osemenyuk-114/RGBtoHDMI/Kicad_6Bit/v7a/SLW-105-01-T-D.step

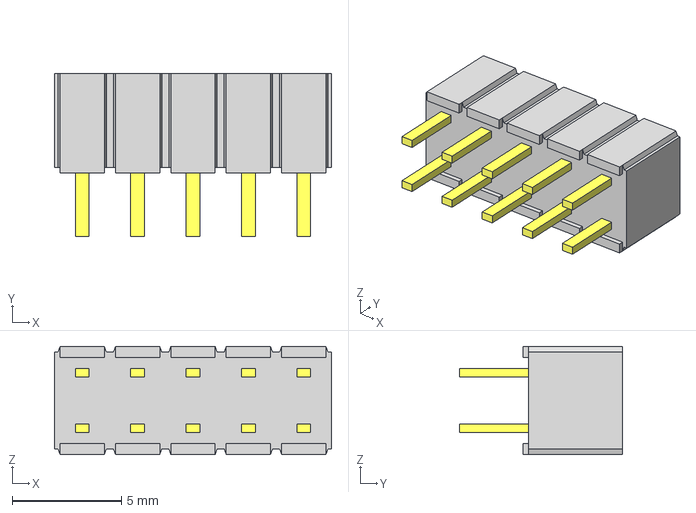
[picture p1: CAD file, 2026-11-09]
Kicad_6Bit/v7a/SLW-105-01-T-D.step
12.7 x 7.49 x 4.95 mm
SLW-105-01-D_socket
C-28-01-05-D
