osemenyuk-114/RGBtoHDMI/Kicad_Analog_6bit/V3a/SSW-106-02-T-D-RA.step

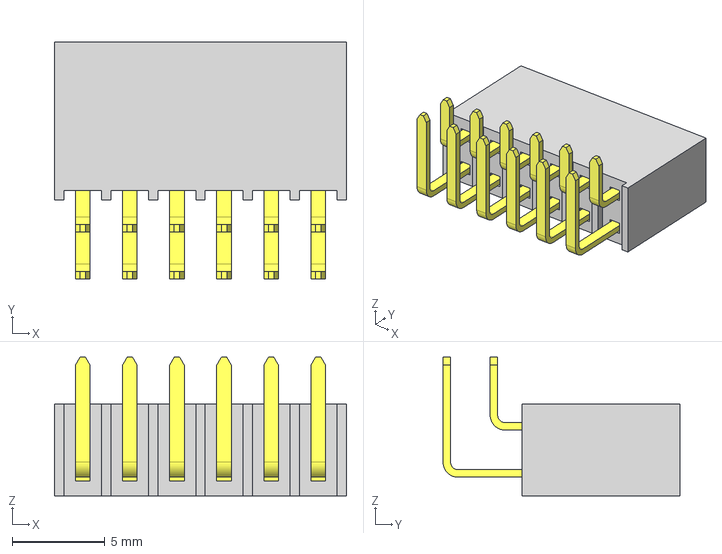
[picture p2: CAD file, 2026-11-09]
Kicad_Analog_6bit/V3a/SSW-106-02-T-D-RA.step
15.7 x 12.8 x 7.48 mm
T1SSW-106-02-T-D-RA
P2SSW-106-02-T-D-RA
