osemenyuk-114/RGBtoHDMI/Kicad_Audio_Adapter/v2a/Oscillator_SMD_SeikoEpson_SG8002CE-4Pin_3.2x2.5mm.step

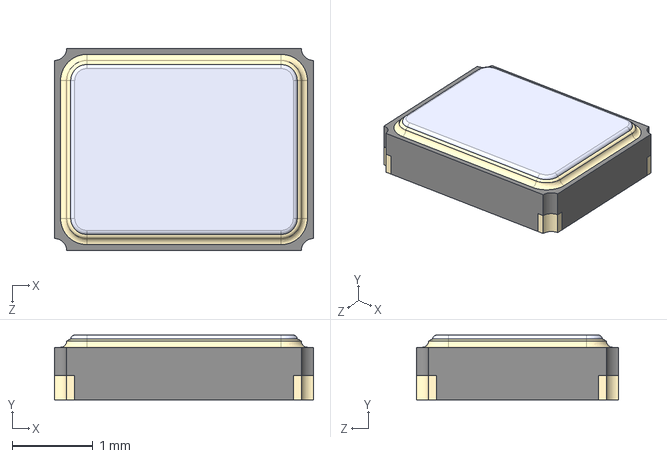
[picture p3: CAD file, 2026-11-09]
Kicad_Audio_Adapter/v2a/Oscillator_SMD_SeikoEpson_SG8002CE-4Pin_3.2x2.5mm.step
3.20 x 0.8 x 2.50 mm
