osemenyuk-114/RGBtoHDMI/Kicad_Analog_6bit/V3a/TLW-104-06-T-S.step

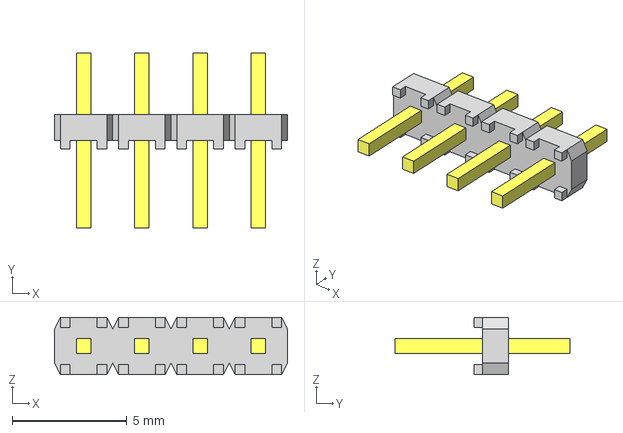
[picture p4: CAD file, 2026-11-09]
Kicad_Analog_6bit/V3a/TLW-104-06-T-S.step
10.2 x 7.62 x 2.49 mm
TLW-104-06-F-S_terminal
TLW-04-06-S0.3
