osemenyuk-114/RGBtoHDMI/Kicad_Analog_6bit/V3a/TLW-101-06-T-S.step

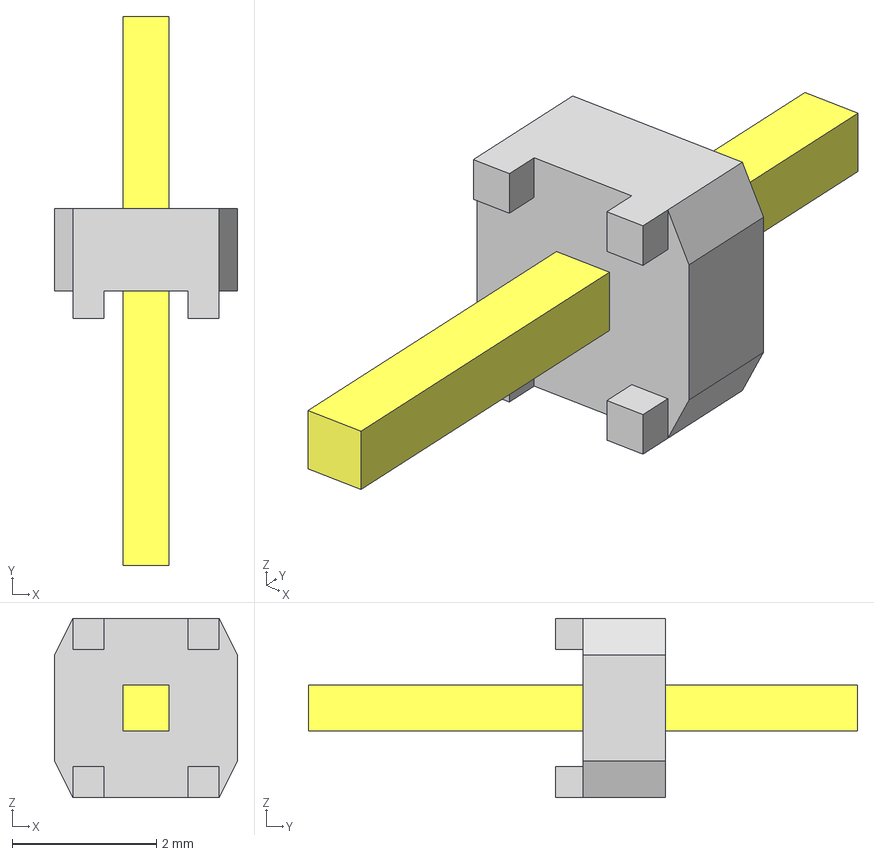
[picture p5: CAD file, 2026-11-09]
Kicad_Analog_6bit/V3a/TLW-101-06-T-S.step
2.54 x 7.62 x 2.49 mm
TLW-101-06-F-S_terminal
TLW-01-06-S0.3
