osemenyuk-114/RGBtoHDMI/Kicad_6Bit/v6a/rgb-to-hdmi.pdf

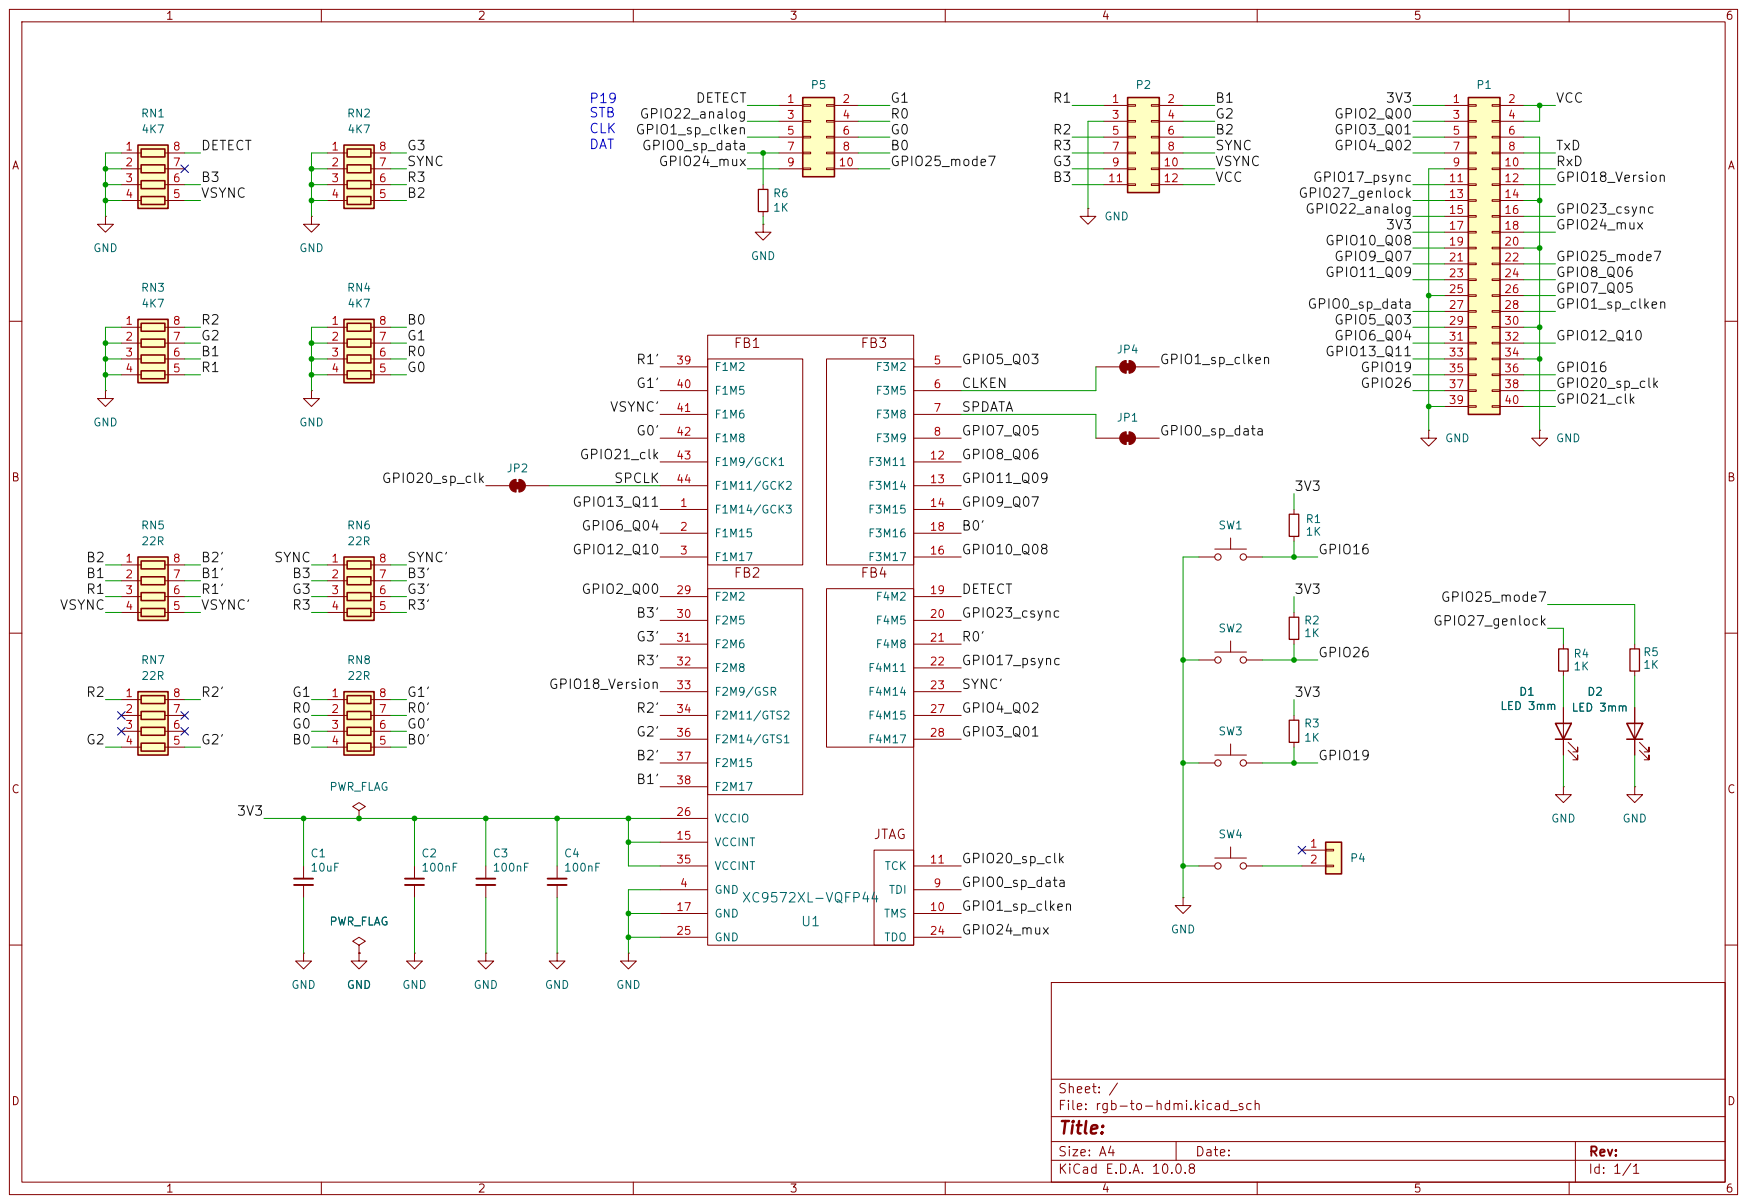
[picture p6: page 1]

Sheet: /
File: rgb-to-hdmi.kicad_sch
Title:

Size: A4 | Rev:
KiCad E.D.A. 10.0.8 | Id: 1/1
