osemenyuk-114/RGBtoHDMI/Kicad_Analog_6bit/V3a/analog.pdf

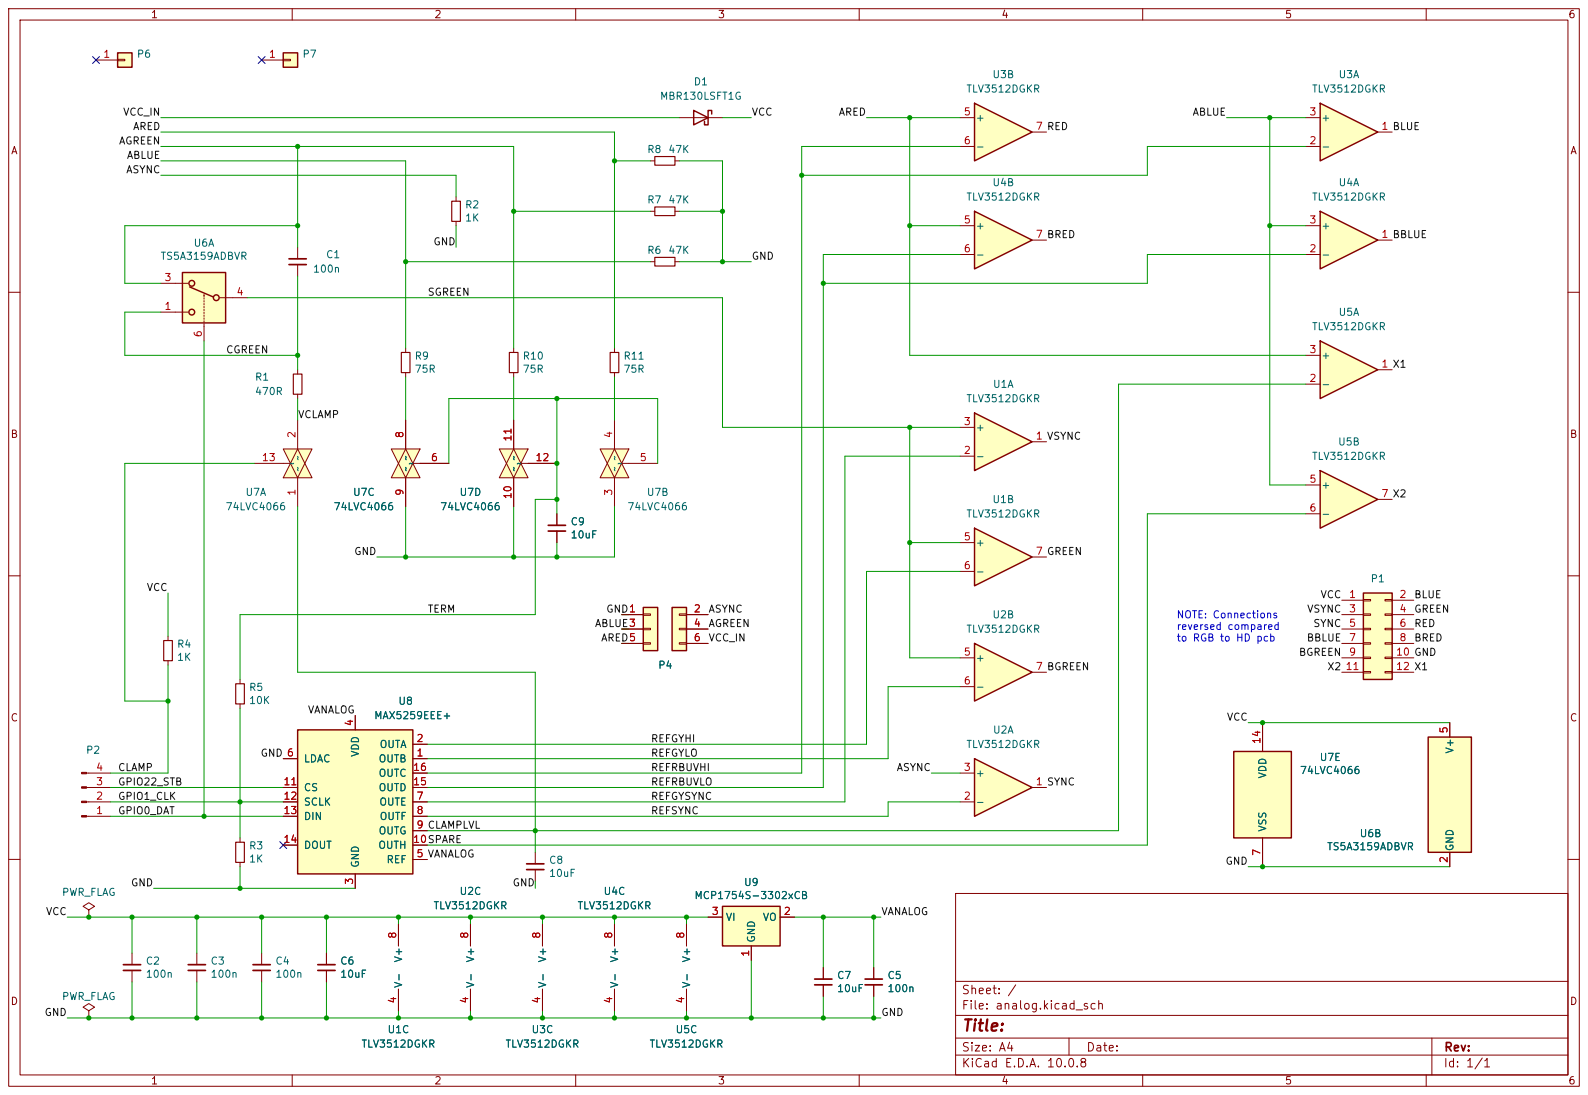
[picture p7: page 1]

Size: A4 | Rev:
KiCad E.D.A. 10.0.8 | Id: 1/1
