osemenyuk-114/RGBtoHDMI/Kicad_Audio_Adapter/v2a/rgbtohdmi-audio.pdf

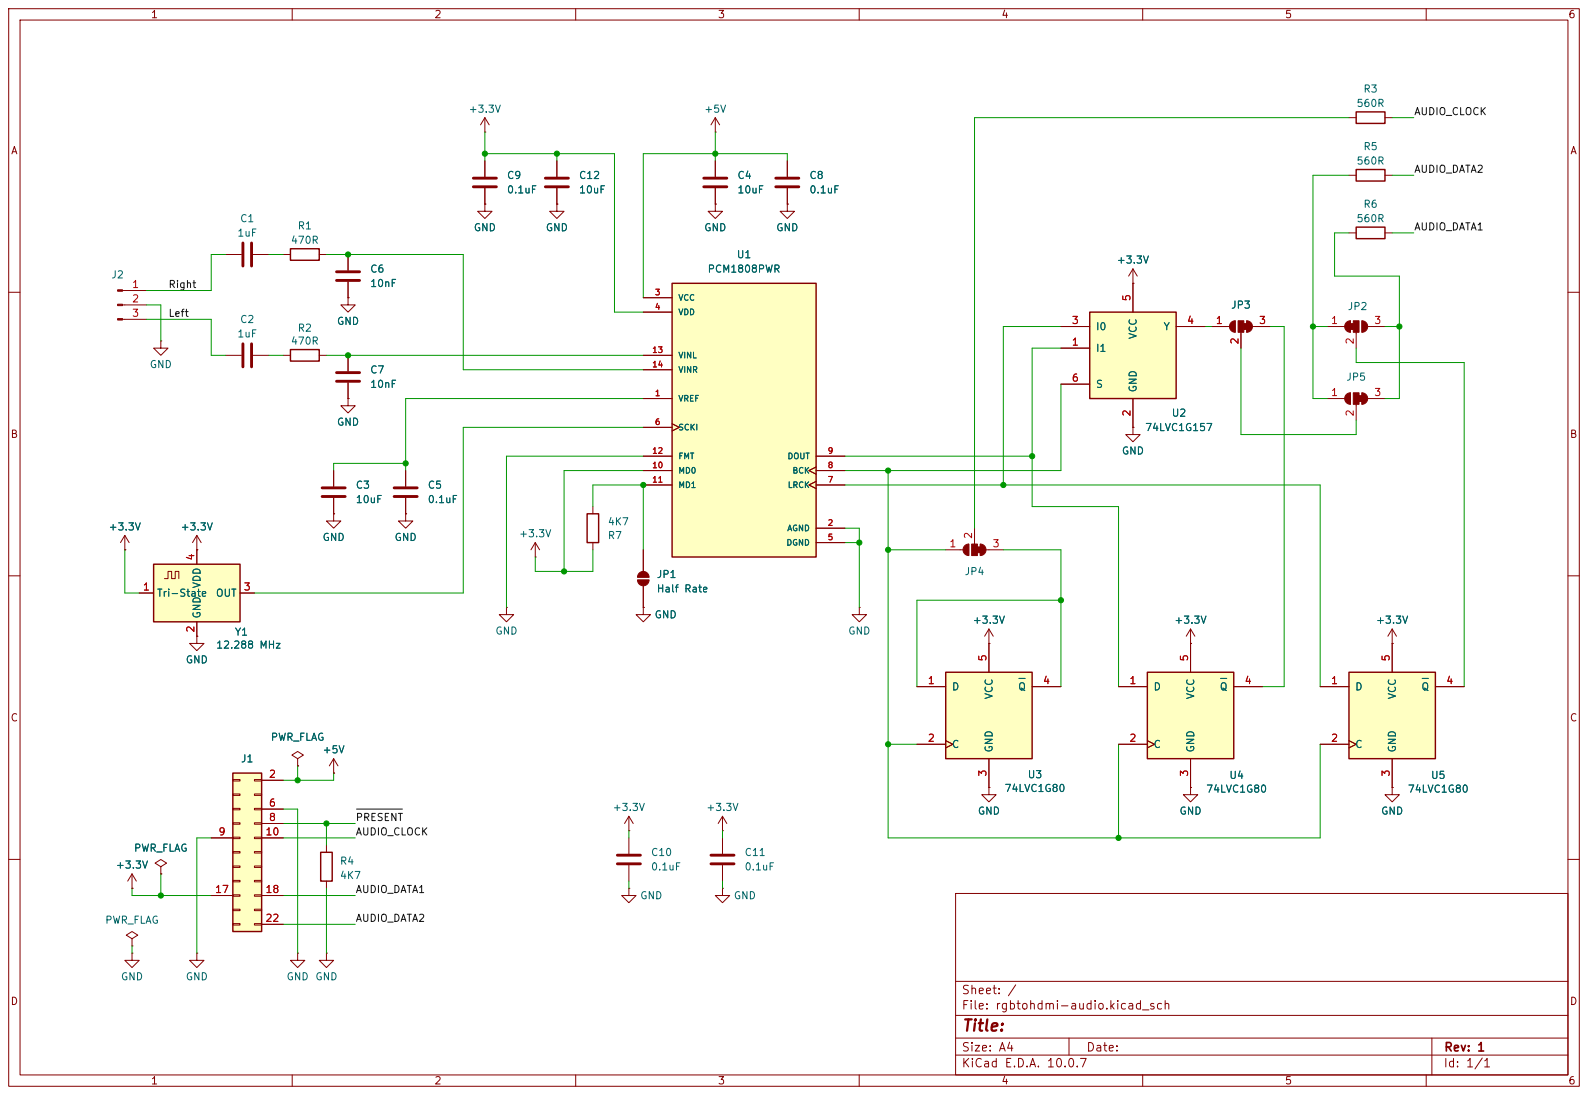
[picture p8: page 1]

Size: A4 | Rev: 1
KiCad E.D.A. 10.0.7 | Id: 1/1
