osemenyuk-114/RGBtoHDMI/Kicad_6Bit/v6a/rgb-to-hdmi.kicad_pcb

## KiCad design Kicad_6Bit/v6a/rgb-to-hdmi.kicad_pcb (2026-11-14)

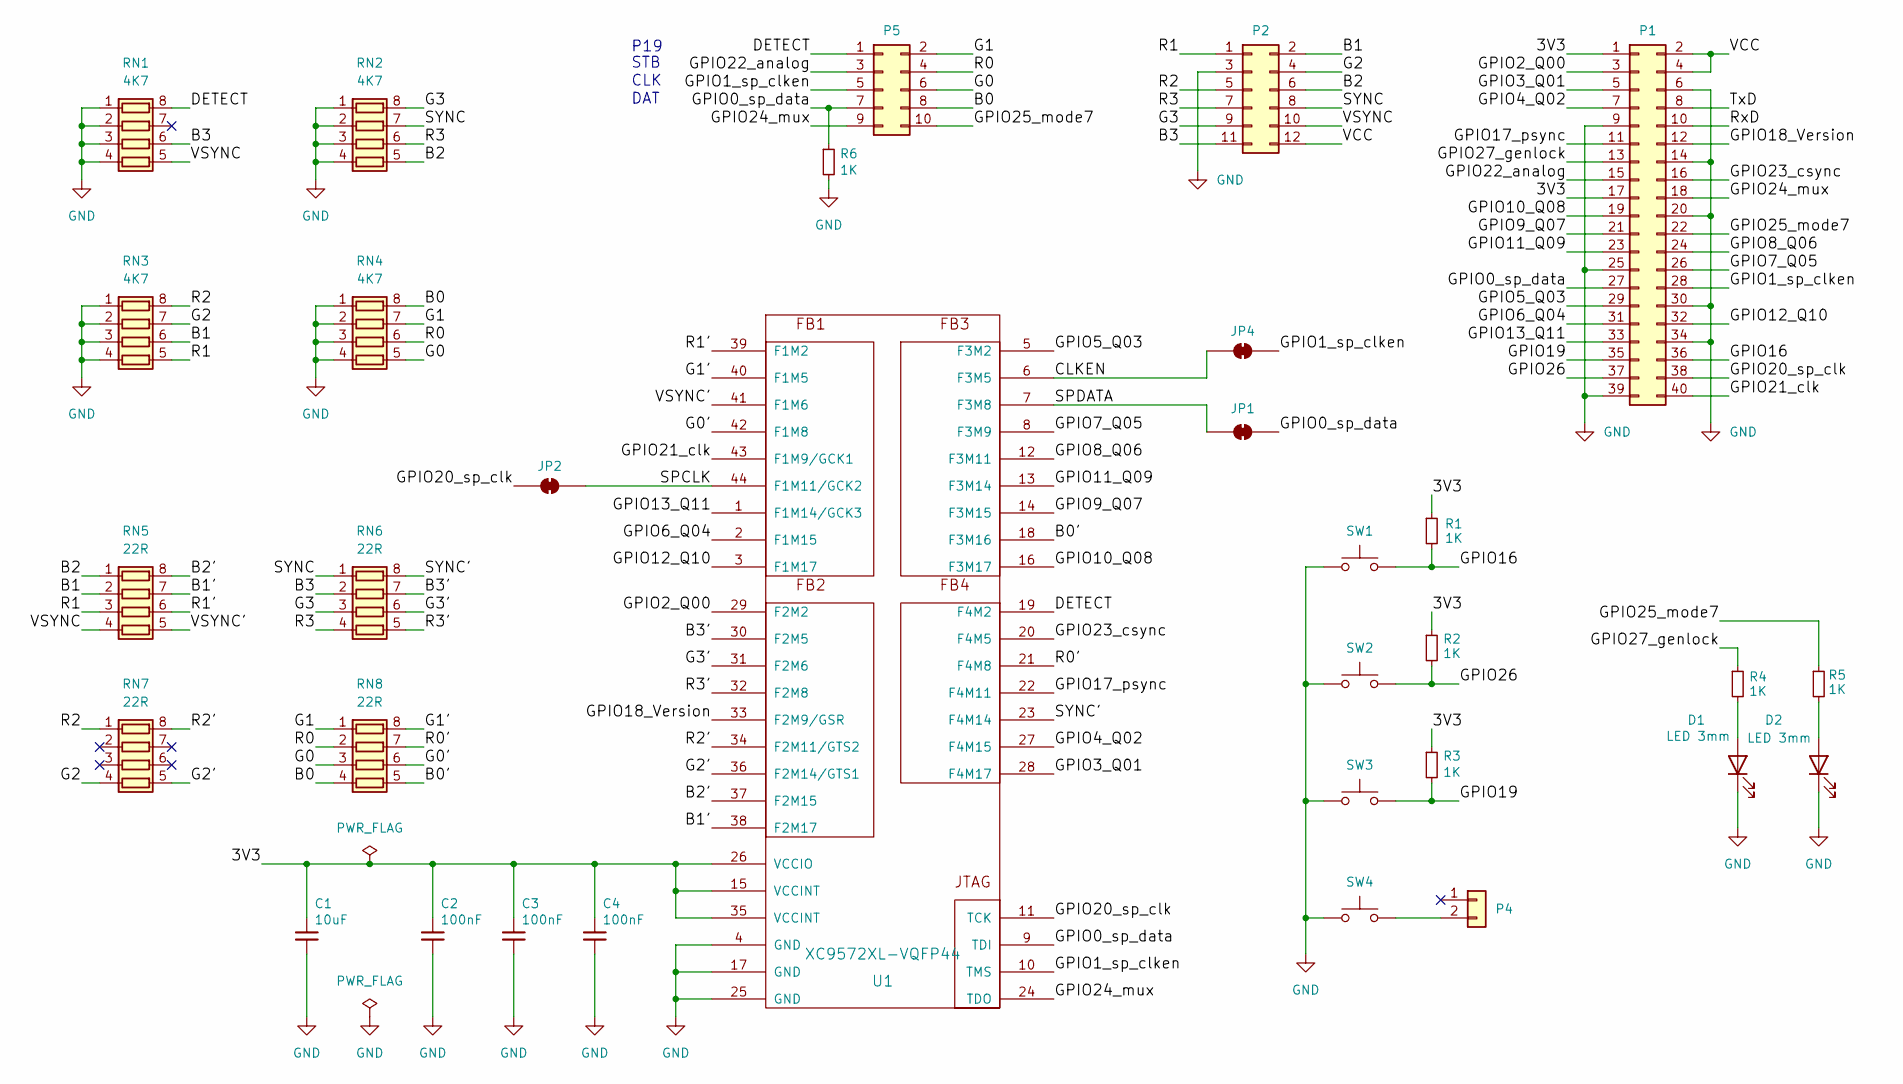
[picture p9: schematic rgb-to-hdmi.kicad_sch]

Parts:
C1: 10uF; C_0805_2012Metric_Pad1.18x1.45mm_HandSolder
C2, C3, C4: 100nF; C_0805_2012Metric_Pad1.18x1.45mm_HandSolder
D1, D2: LED 3mm; LED_D3.0mm
JP1, JP2, JP4: Solder Jumper 2 Bridged; SolderJumper-2_P1.3mm_Bridged_RoundedPad1.0x1.5mm
P1: Wurth Elektronik 61304021821; PinSocket_2x20_P2.54mm_Vertical
P2: Samtec TSW-106-08-L-D-RA; PinHeader_2x06_P2.54mm_Horizontal
P4: Wurth Elektronik 61300211821; PinSocket_1x02_P2.54mm_Vertical
P5: Samtec SLW-105-01-T-D; PinSocket_2x05_P2.54mm_Vertical
R1, R2, R3, R4, R5, R6: 1K; R_0603_1608Metric_Pad0.98x0.95mm_HandSolder
RN1, RN2, RN3, RN4: 4K7; R_Array_Convex_4x0603
RN5, RN6, RN7, RN8: 22R; R_Array_Convex_4x0603
SW1, SW2, SW3, SW4: Alps Alpine SKHHBVA010; SW_PUSH_6mm_H7.3mm
U1: XC9572XL-VQFP44; LQFP-44_10x10mm_P0.8mm

Connections:
/3V3: C1.1, C2.1, C3.1, C4.1, P1.1, P1.17, R1.1, R2.1, R3.1, U1.15 (VCCINT), U1.26 (VCCIO), U1.35 (VCCINT)
/B0: P5.8, RN4.8 (R1.2), RN8.4 (R4.1)
/B0': RN8.5 (R4.2), U1.18 (F3M16)
/B1: P2.2, RN3.6 (R3.2), RN5.2 (R2.1)
/B1': RN5.7 (R2.2), U1.38 (F2M17)
/B2: P2.6, RN2.5 (R4.2), RN5.1 (R1.1)
/B2': RN5.8 (R1.2), U1.37 (F2M15)
/B3: P2.11, RN1.6 (R3.2), RN6.2 (R2.1)
/B3': RN6.7 (R2.2), U1.30 (F2M5)
/CLKEN: JP4.2 (B), U1.6 (F3M5)
/DETECT: P5.1, RN1.8 (R1.2), U1.19 (F4M2)
/G0: P5.6, RN4.5 (R4.2), RN8.3 (R3.1)
/G0': RN8.6 (R3.2), U1.42 (F1M8)
/G1: P5.2, RN4.7 (R2.2), RN8.1 (R1.1)
/G1': RN8.8 (R1.2), U1.40 (F1M5)
/G2: P2.4, RN3.7 (R2.2), RN7.4 (R4.1)
/G2': RN7.5 (R4.2), U1.36 (F2M14/GTS1)
/G3: P2.9, RN2.8 (R1.2), RN6.3 (R3.1)
/G3': RN6.6 (R3.2), U1.31 (F2M6)
/GPIO0_sp_data: JP1.1 (A), P1.27, P5.7, R6.1, U1.9 (TDI)
/GPIO1_sp_clken: JP4.1 (A), P1.28, P5.5, U1.10 (TMS)
/GPIO2_Q00: P1.3, U1.29 (F2M2)
/GPIO3_Q01: P1.5, U1.28 (F4M17)
/GPIO4_Q02: P1.7, U1.27 (F4M15)
/GPIO5_Q03: P1.29, U1.5 (F3M2)
/GPIO6_Q04: P1.31, U1.2 (F1M15)
/GPIO7_Q05: P1.26, U1.8 (F3M9)
/GPIO8_Q06: P1.24, U1.12 (F3M11)
/GPIO9_Q07: P1.21, U1.14 (F3M15)
/GPIO10_Q08: P1.19, U1.16 (F3M17)
/GPIO11_Q09: P1.23, U1.13 (F3M14)
/GPIO12_Q10: P1.32, U1.3 (F1M17)
/GPIO13_Q11: P1.33, U1.1 (F1M14/GCK3)
/GPIO16: P1.36, R1.2, SW1.2
/GPIO17_psync: P1.11, U1.22 (F4M11)
/GPIO18_Version: P1.12, U1.33 (F2M9/GSR)
/GPIO19: P1.35, R3.2, SW3.2
/GPIO20_sp_clk: JP2.1 (A), P1.38, U1.11 (TCK)
/GPIO21_clk: P1.40, U1.43 (F1M9/GCK1)
/GPIO22_analog: P1.15, P5.3
/GPIO23_csync: P1.16, U1.20 (F4M5)
/GPIO24_mux: P1.18, P5.9, U1.24 (TDO)
/GPIO25_mode7: P1.22, P5.10, R5.1
/GPIO26: P1.37, R2.2, SW2.2
/GPIO27_genlock: P1.13, R4.1
/R0: P5.4, RN4.6 (R3.2), RN8.2 (R2.1)
/R0': RN8.7 (R2.2), U1.21 (F4M8)
/R1: P2.1, RN3.5 (R4.2), RN5.3 (R3.1)
/R1': RN5.6 (R3.2), U1.39 (F1M2)
/R2: P2.5, RN3.8 (R1.2), RN7.1 (R1.1)
/R2': RN7.8 (R1.2), U1.34 (F2M11/GTS2)
/R3: P2.7, RN2.6 (R3.2), RN6.4 (R4.1)
/R3': RN6.5 (R4.2), U1.32 (F2M8)
/RxD: P1.10
/SPCLK: JP2.2 (B), U1.44 (F1M11/GCK2)
/SPDATA: JP1.2 (B), U1.7 (F3M8)
/SYNC: P2.8, RN2.7 (R2.2), RN6.1 (R1.1)
/SYNC': RN6.8 (R1.2), U1.23 (F4M14)
/TxD: P1.8
/VCC: P1.2, P1.4, P2.12
/VSYNC: P2.10, RN1.5 (R4.2), RN5.4 (R4.1)
/VSYNC': RN5.5 (R4.2), U1.41 (F1M6)
GND: C1.2, C2.2, C3.2, C4.2, D1.1 (K), D2.1 (K), P1.6, P1.9, P1.14, P1.20, P1.25, P1.30, P1.34, P1.39, P2.3, R6.2, RN1.1 (R1.1), RN1.2 (R2.1), RN1.3 (R3.1), RN1.4 (R4.1), RN2.1 (R1.1), RN2.2 (R2.1), RN2.3 (R3.1), RN2.4 (R4.1), RN3.1 (R1.1), RN3.2 (R2.1), RN3.3 (R3.1), RN3.4 (R4.1), RN4.1 (R1.1), RN4.2 (R2.1), RN4.3 (R3.1), RN4.4 (R4.1), SW1.1, SW2.1, SW3.1, SW4.1, U1.4 (GND), U1.17 (GND), U1.25 (GND)
unnamed: D1.2 (A), R4.2
unnamed: D2.2 (A), R5.2
unnamed: P4.2 (Pin_2_2), SW4.2

Notes on the sheet:
DAT
P19
CLK
STB

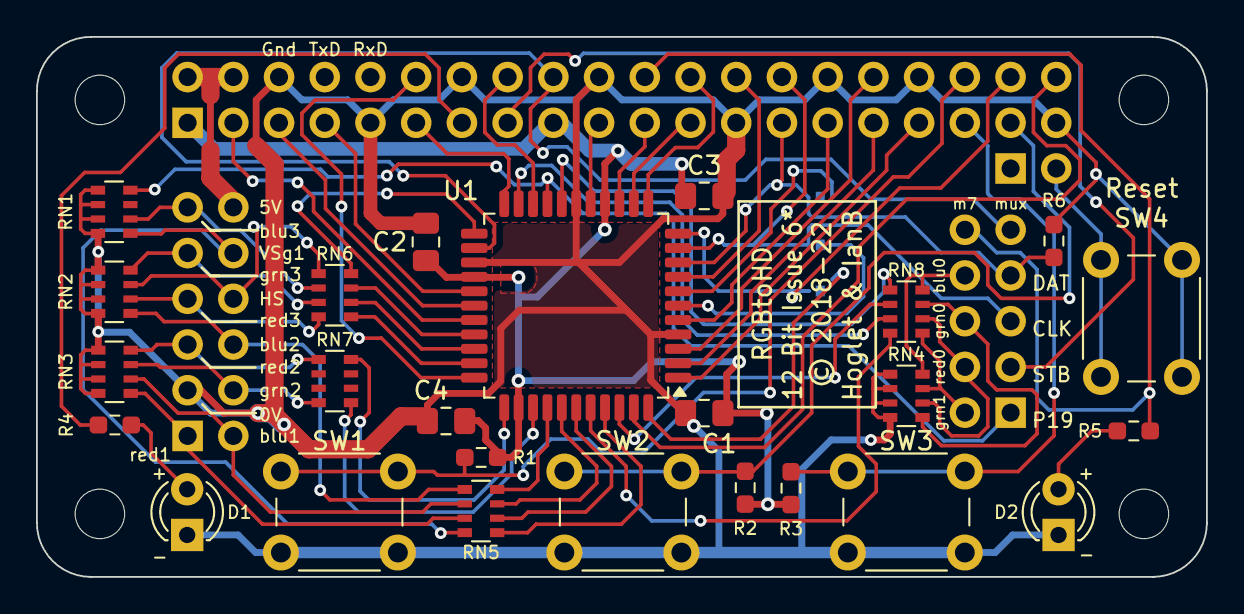
[picture p10: board rgb-to-hdmi.kicad_pcb from above]

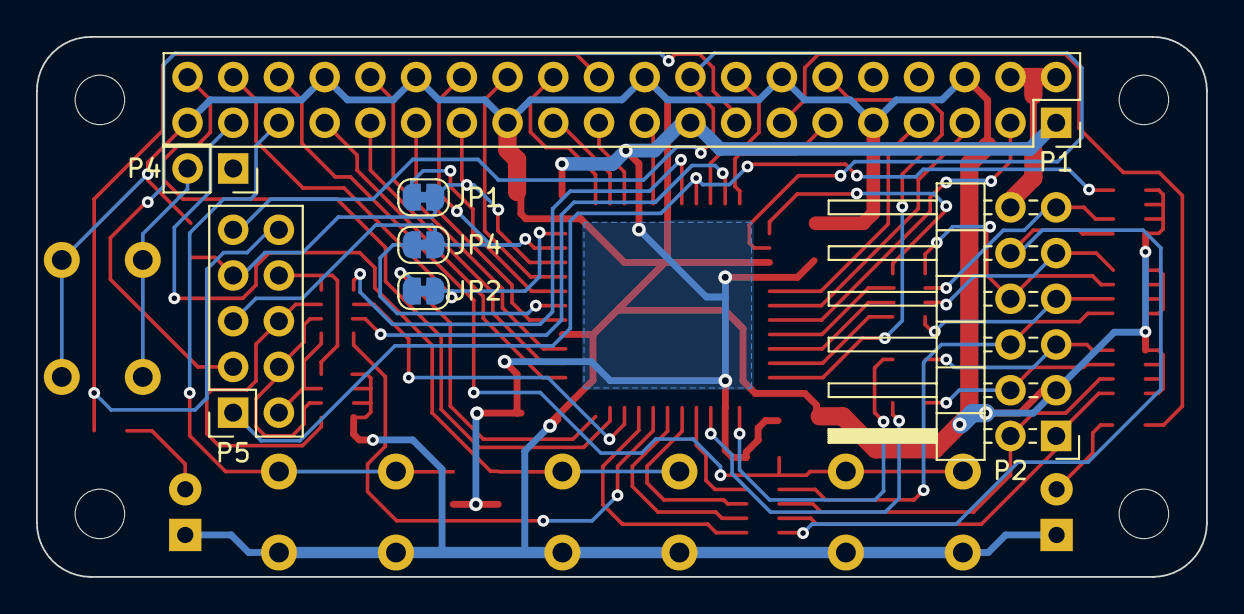
[picture p11: board rgb-to-hdmi.kicad_pcb from below]

Board: 2 copper layers, 65.0 x 30.0 mm, 32 parts (7 on the bottom side), 64 nets.
