osemenyuk-114/RGBtoHDMI/Kicad_Analog_6bit/V3a/analog.kicad_pcb

## KiCad design Kicad_Analog_6bit/V3a/analog.kicad_pcb (2026-11-12)

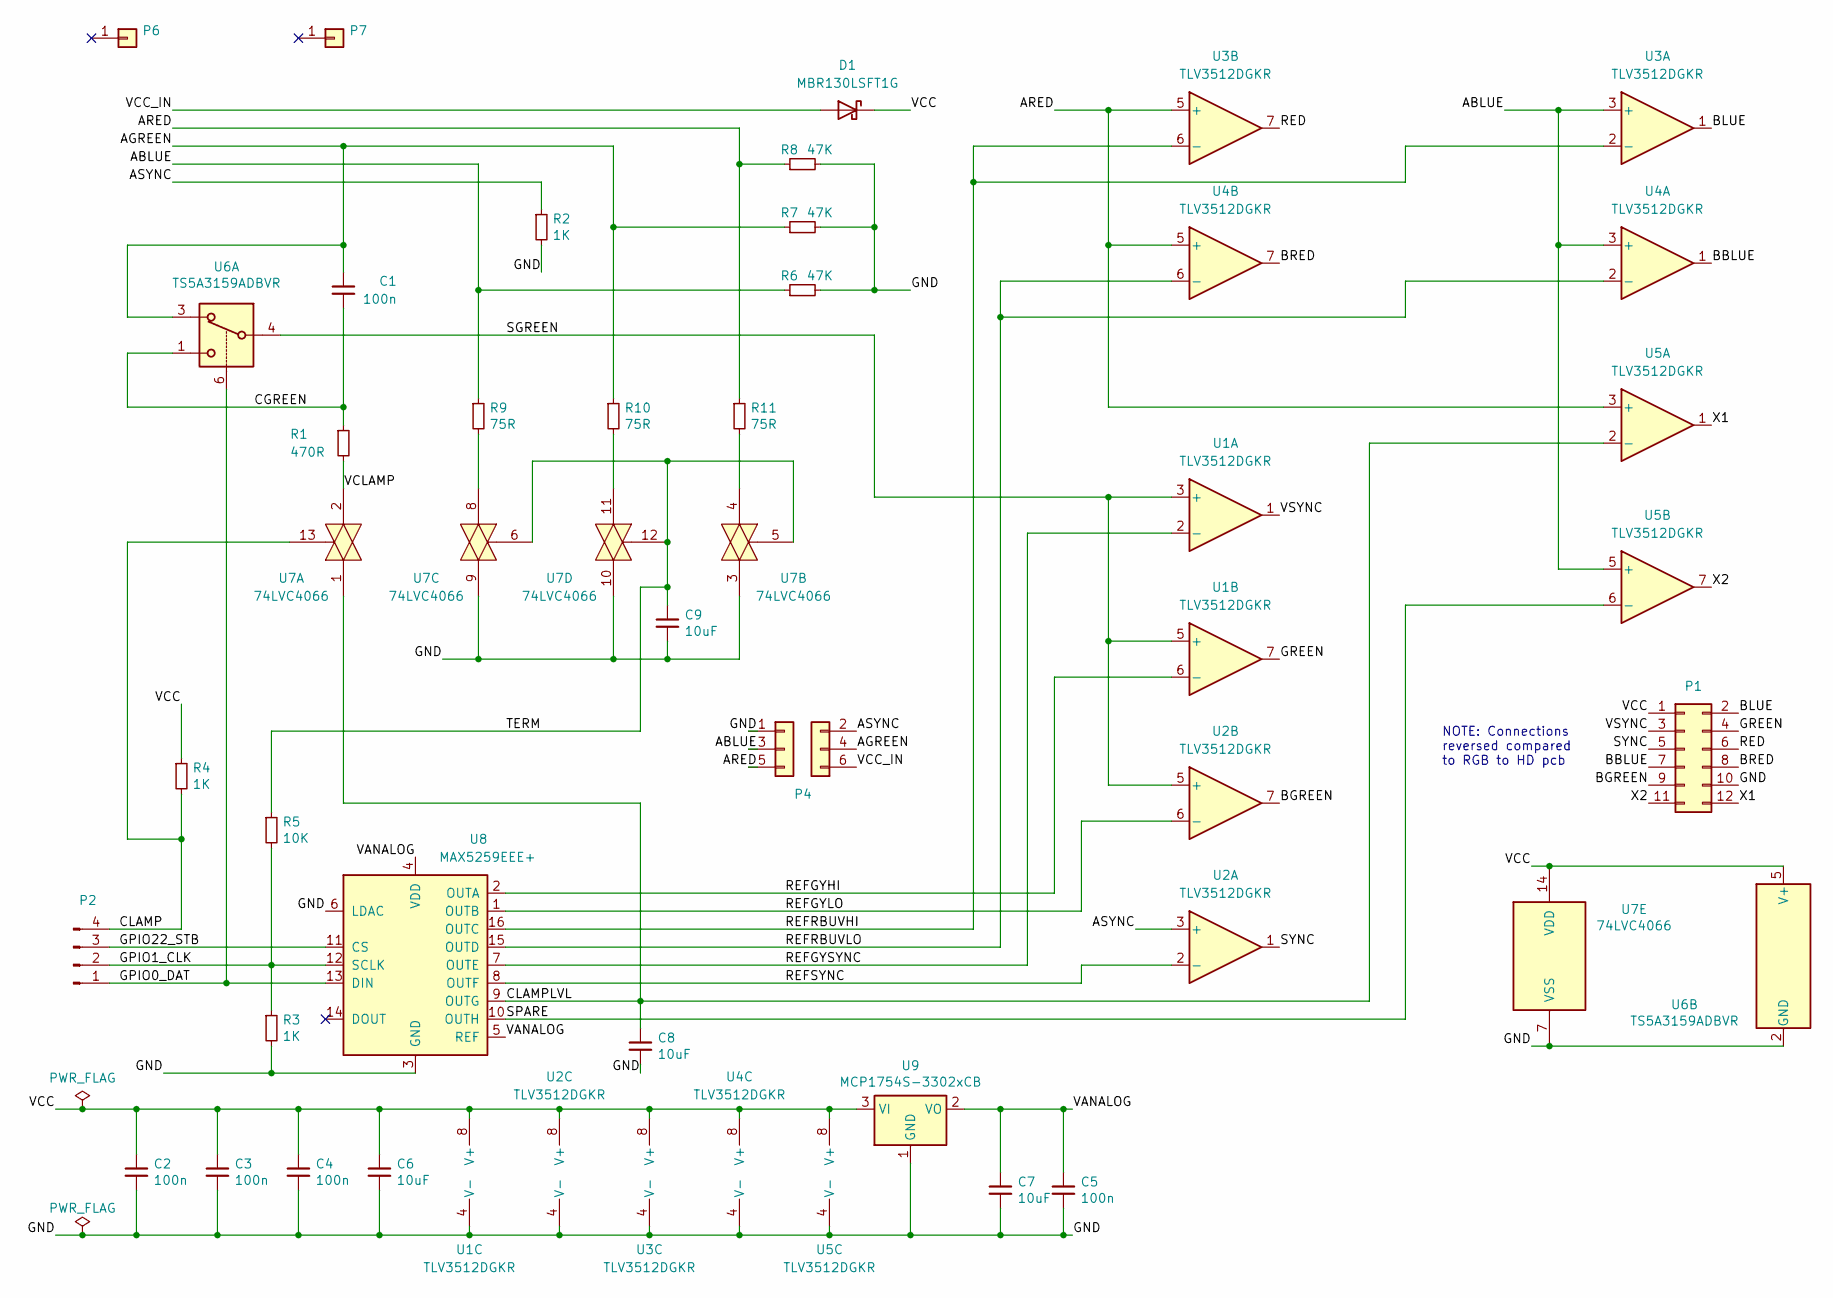
[picture p12: schematic analog.kicad_sch]

Parts:
C1, C2, C3, C4, C5: 100n; C_0805_2012Metric_Pad1.18x1.45mm_HandSolder
C6, C7, C8, C9: 10uF; C_0805_2012Metric_Pad1.18x1.45mm_HandSolder
D1: MBR130LSFT1G; D_SOD-123
P1: Samtec SSW-106-02-T-D-RA; PinSocket_2x06_P2.54mm_Horizontal
P2: Samtec TLW-104-06-T-S; PinHeader_1x04_P2.54mm_Vertical
P4: IDC 6pin; Harwin_M20-89003xx_1x03_P2.54mm_Horizontal_Custom_ODD2
P5: Conn_01x03_EVEN; Harwin_M20-89003xx_1x03_P2.54mm_Horizontal_Custom_EVEN2
P6, P7: Samtec TLW-101-06-T-S; PinHeader_1x01_P2.54mm_Vertical
R1: 470R; R_0805_2012Metric_Pad1.20x1.40mm_HandSolder
R2, R3, R4: 1K; R_0805_2012Metric_Pad1.20x1.40mm_HandSolder
R5: 10K; R_0805_2012Metric_Pad1.20x1.40mm_HandSolder
R6, R7, R8: 47K; R_0805_2012Metric_Pad1.20x1.40mm_HandSolder
R9, R10, R11: 75R; R_0805_2012Metric_Pad1.20x1.40mm_HandSolder
U1, U2, U3, U4, U5: TLV3512DGKR; SSOP-8_2.95x2.8mm_P0.65mm
U6: TS5A3159ADBVR; SOT-23-6_Handsoldering
U7: 74LVC4066; SOIC-14_3.9x8.7mm_P1.27mm
U8: MAX5259EEE+; QSOP-16_3.9x4.9mm_P0.635mm
U9: MCP1754S-3302xCB; SOT-23_Handsoldering

Connections:
/ABLUE: P4.3, R6.1, R9.1, U3.3 (+), U4.3 (+), U5.5 (+)
/AGREEN: C1.1, P5.4, R7.1, R10.1, U6.3
/ARED: P4.5, R8.1, R11.1, U3.5 (+), U4.5 (+), U5.3 (+)
/ASYNC: P5.2, R2.1, U2.3 (+)
/BBLUE: P1.7, U4.1
/BGREEN: P1.9, U2.7
/BLUE: P1.2, U3.1
/BRED: P1.8, U4.7
/CGREEN: C1.2, R1.1, U6.1
/CLAMP: P2.4, R4.2, U7.13
/CLAMPLVL: C8.1, U5.2 (-), U7.1, U8.9 (OUTG)
/GND: C2.2, C3.2, C4.2, C5.2, C6.2, C7.2, C8.2, C9.2, P1.10, P4.1, R2.2, R3.2, R6.2, R7.2, R8.2, U1.4 (V-), U2.4 (V-), U3.4 (V-), U4.4 (V-), U5.4 (V-), U6.2 (GND), U7.3, U7.7 (VSS), U7.9, U7.10, U8.3 (GND), U8.6 (LDAC), U9.1 (GND)
/GPIO0_DAT: P2.1, U6.6, U8.13 (DIN)
/GPIO1_CLK: P2.2, R3.1, R5.2, U8.12 (SCLK)
/GPIO22_STB: P2.3, U8.11 (CS)
/GREEN: P1.4, U1.7
/RED: P1.6, U3.7
/REFGYHI: U1.6 (-), U8.2 (OUTA)
/REFGYLO: U2.6 (-), U8.1 (OUTB)
/REFGYSYNC: U1.2 (-), U8.7 (OUTE)
/REFRBUVHI: U3.2 (-), U3.6 (-), U8.16 (OUTC)
/REFRBUVLO: U4.2 (-), U4.6 (-), U8.15 (OUTD)
/REFSYNC: U2.2 (-), U8.8 (OUTF)
/SGREEN: U1.3 (+), U1.5 (+), U2.5 (+), U6.4
/SPARE: U5.6 (-), U8.10 (OUTH)
/SYNC: P1.5, U2.1
/TERM: C9.1, R5.1, U7.5, U7.6, U7.12
/VANALOG: C5.1, C7.1, U8.4 (VDD), U8.5 (REF), U9.2 (VO)
/VCC: C2.1, C3.1, C4.1, C6.1, D1.1 (K), P1.1, R4.1, U1.8 (V+), U2.8 (V+), U3.8 (V+), U4.8 (V+), U5.8 (V+), U6.5 (V+), U7.14 (VDD), U9.3 (VI)
/VCC_IN: D1.2 (A), P5.6
/VCLAMP: R1.2, U7.2
/VSYNC: P1.3, U1.1
/X1: P1.12, U5.1
/X2: P1.11, U5.7
unnamed: R9.2, U7.8
unnamed: R10.2, U7.11
unnamed: R11.2, U7.4

Notes on the sheet:
NOTE: Connections reversed compared to RGB to HD pcb

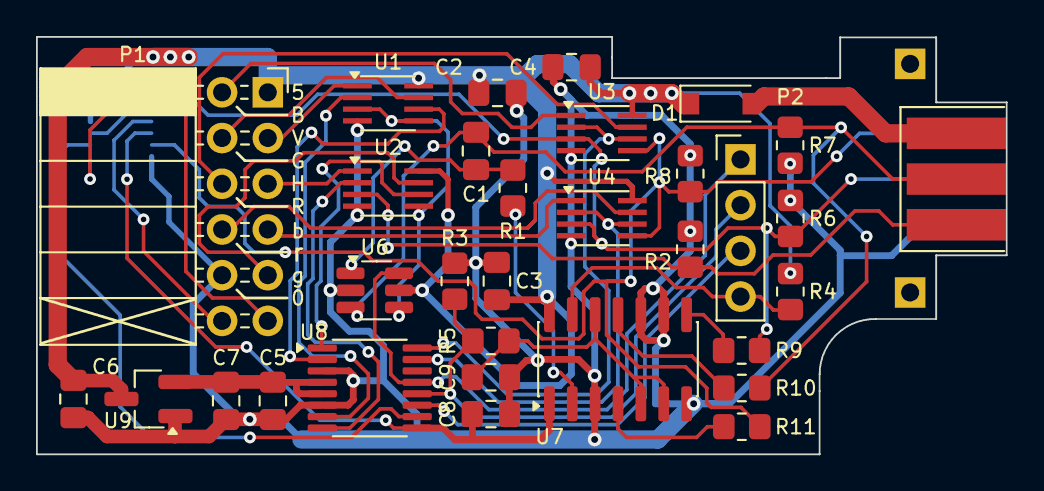
[picture p13: board analog.kicad_pcb from above]

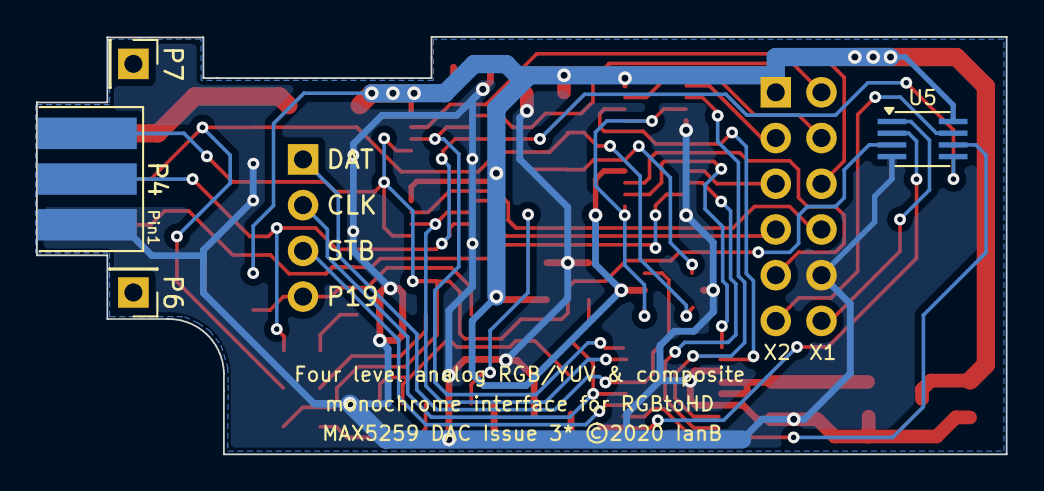
[picture p14: board analog.kicad_pcb from below]

Board: 2 copper layers, 53.9 x 23.2 mm, 36 parts (4 on the bottom side), 37 nets.
