osemenyuk-114/RGBtoHDMI/Kicad_Audio_Adapter/v2a/rgbtohdmi-audio.kicad_pcb

## KiCad design Kicad_Audio_Adapter/v2a/rgbtohdmi-audio.kicad_pcb (2026-11-09)

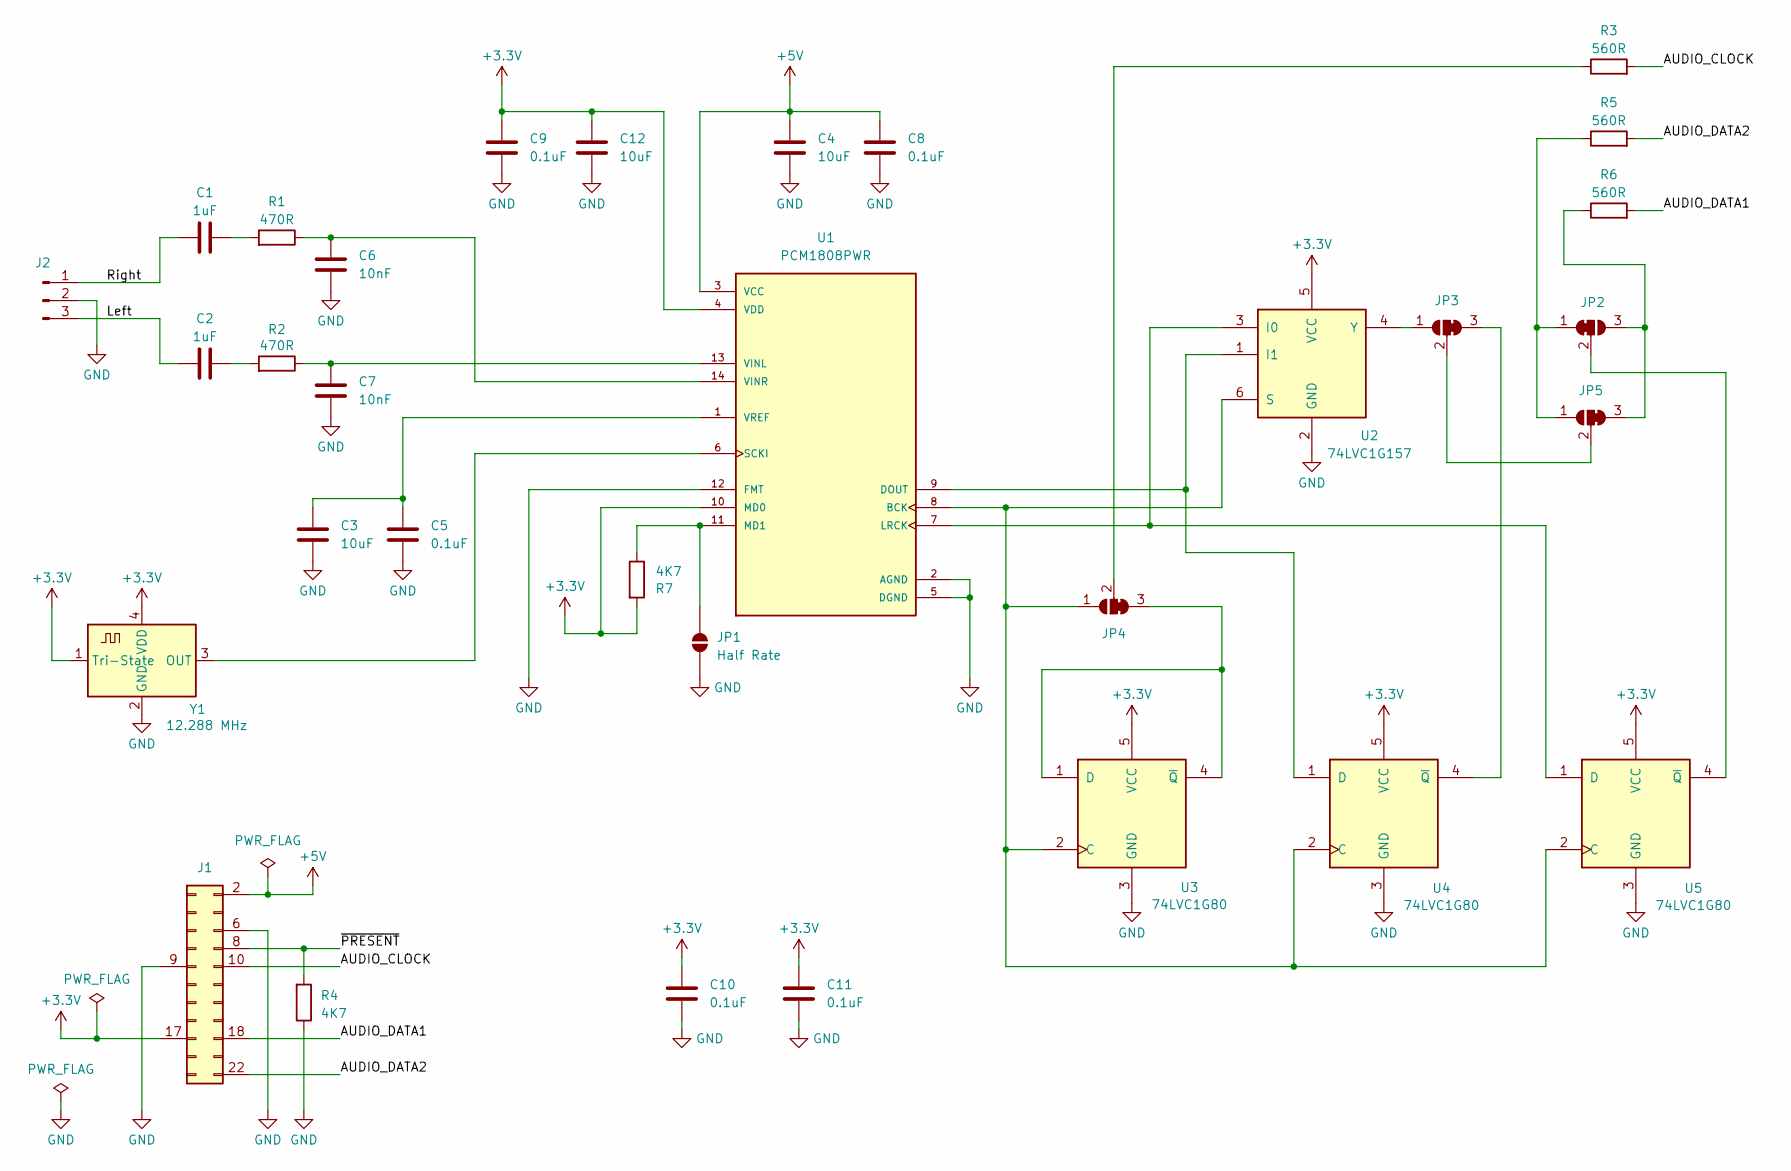
[picture p15: schematic rgbtohdmi-audio.kicad_sch]

Parts:
C1, C2: 1uF; C_0603_1608Metric_Pad1.08x0.95mm_HandSolder
C3, C4, C12: 10uF; C_0603_1608Metric_Pad1.08x0.95mm_HandSolder
C5, C8, C9, C10, C11: 0.1uF; C_0603_1608Metric_Pad1.08x0.95mm_HandSolder
C6, C7: 10nF; C_0603_1608Metric_Pad1.08x0.95mm_HandSolder
J1: Conn_02x11_Odd_Even; PinHeader_2x11_P2.54mm_Vertical
J2: Conn_01x03; SolderWirePad_1x03_SMD_2x4mm
JP1: Half Rate; SolderJumper-2_P1.3mm_Open_RoundedPad1.0x1.5mm
JP2: SolderJumper_3_Bridged12; SolderJumper-3_P1.3mm_Bridged12_RoundedPad1.0x1.5mm
JP3, JP4, JP5: SolderJumper-3_P1.3mm_Bridged23_RoundedPad1.0x1.5mm
R1, R2: 470R; R_0603_1608Metric_Pad0.98x0.95mm_HandSolder
R3, R5, R6: 560R; R_0603_1608Metric_Pad0.98x0.95mm_HandSolder
R4, R7: 4K7; R_0603_1608Metric_Pad0.98x0.95mm_HandSolder
U1: PCM1808PWR; TSSOP-14_4.4x5mm_P0.65mm; PARTREV B
U2: 74LVC1G157; SOT-363_SC-70-6
U3, U4, U5: 74LVC1G80; SOT-353_SC-70-5
Y1: 12.288 MHz; Oscillator_SMD_SeikoEpson_SG8002CE-4Pin_3.2x2.5mm

Connections:
+3.3V: C9.1, C10.1, C11.1, C12.1, J1.17, R7.2, U1.4 (VDD), U1.10 (MD0), U2.5 (VCC), U3.5 (VCC), U4.5 (VCC), U5.5 (VCC), Y1.1 (Tri-State), Y1.4 (VDD)
+5V: C4.1, C8.1, J1.2, U1.3 (VCC)
/AUDIO_CLOCK: J1.10, R3.2
/AUDIO_DATA1: J1.18, R6.2
/AUDIO_DATA2: J1.22, R5.2
/Left: C2.2, J2.3
/Right: C1.2, J2.1
/~PRESENT: J1.8, R4.2
GND: C3.2, C4.2, C5.2, C6.2, C7.2, C8.2, C9.2, C10.2, C11.2, C12.2, J1.6, J1.9, J2.2, JP1.2 (B), R4.1, U1.2 (AGND), U1.5 (DGND), U1.12 (FMT), U2.2 (GND), U3.3 (GND), U4.3 (GND), U5.3 (GND), Y1.2 (GND)
unnamed: C1.1, R1.2
unnamed: C2.1, R2.2
unnamed: JP1.1 (A), R7.1, U1.11 (MD1)
unnamed: JP2.1 (A), JP5.1 (A), R5.1
unnamed: JP2.3 (B), JP5.3 (B), R6.1
unnamed: JP2.2 (C), U5.4 (~Q)
unnamed: JP3.1 (A), U2.4 (Y)
unnamed: JP3.3 (B), U4.4 (~Q)
unnamed: JP3.2 (C), JP5.2 (C)
unnamed: JP4.1 (A), U1.8 (BCK), U2.6 (S), U3.2 (C), U4.2 (C), U5.2 (C)
unnamed: JP4.3 (B), U3.1 (D), U3.4 (~Q)
unnamed: JP4.2 (C), R3.1
unnamed: U1.9 (DOUT), U2.1 (I1), U4.1 (D)
unnamed: U1.7 (LRCK), U2.3 (I0), U5.1 (D)
unnamed: U1.6 (SCKI), Y1.3 (OUT)
unnamed: C7.1, R2.1, U1.13 (VINL)
unnamed: C6.1, R1.1, U1.14 (VINR)
unnamed: C3.1, C5.1, U1.1 (VREF)

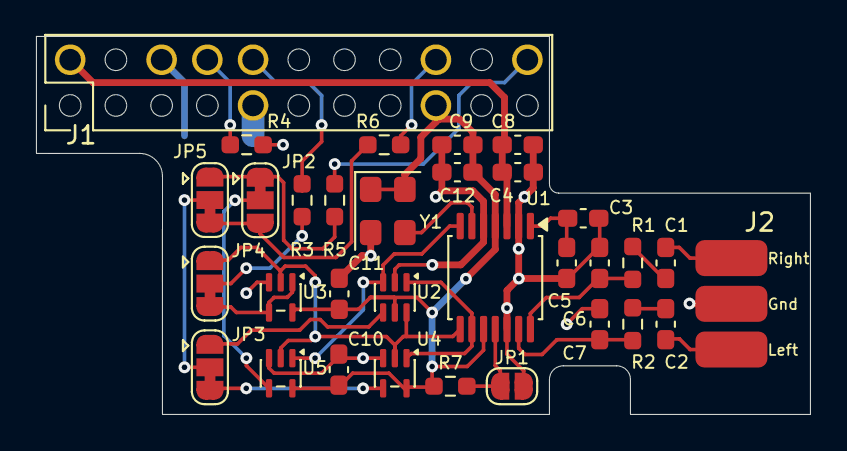
[picture p16: board rgbtohdmi-audio.kicad_pcb from above]

Board: 2 copper layers, 43.0 x 21.0 mm, 32 parts (0 on the bottom side), 27 nets.
