osemenyuk-114/RGBtoHDMI/(commit log)

2026-10-10 Update .gitignore and adjust junction and wire coordinates in rgbtohdmi-audio schematic
    [rgbtohdmi-audio.kicad_sch]
2026-11-09 Update designs
    Revise schematics, PCB layouts, BOMs, and manufacturing outputs.
    Update README with board details and version differences.
    [Oscillator_SMD_SeikoEpson_SG8002CE-4Pin_3.2x2.5mm.step, SLW-105-01-T-D.step, SSW-106-02-T-D-RA.step, TLW-101-06-T-S.step, TLW-104-06-T-S.step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]
2026-11-09 Refactor README: restructure layout, unify BOM tables, and update board details
2026-11-09 Format BOM tables with fixed-width HTML for perfect vertical alignment
2026-11-09 Update README: clarify THT switch motivation and specify 0.8mm PCB thickness for audio adapter
2026-11-12 Update README.md to reflect changes in Analog Board V3a components
    - Replaced `TC75W57FU` quad comparators with `TLV3512DGKR` dual comparators for cost optimization.
    - Added a warning indicating that the board has not been built or tested yet.
    [analog.kicad_pcb, analog.kicad_sch]
2026-11-13 Update README.md to reflect changes in CPLD Board section
    - Added V7a replica
    [SLW-105-01-T-D.step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]
2026-11-14 Update V6a CPLD board
    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
    [rgb-to-hdmi-B_Cu.gbl, rgb-to-hdmi-B_Mask.gbs, rgb-to-hdmi-B_Silkscreen.gbo, rgb-to-hdmi-Edge_Cuts.gm1, rgb-to-hdmi-F_Cu.gtl, rgb-to-hdmi-F_Mask.gts, rgb-to-hdmi-F_Silkscreen.gto, rgb-to-hdmi-NPTH.drl]
