osemenyuk-114/RGBtoHDMI/(notices)

Notices in the files:
Kicad_6Bit/v7a/SLW-105-01-T-D.step:
author */ ('License CC BY-ND 4.0'),
Kicad_Analog_6bit/V3a/analog.kicad_pcb:
MAX5259 DAC Issue 3* ©2020 IanB
README.md:
License: GPL v3
Kicad_6Bit/v7a/rgb-to-hdmi.kicad_pcb:
© 2018-23
Kicad_6Bit/v6a/rgb-to-hdmi.kicad_pcb:
© 2018-22
